SteveMayze/GoGoGo/MotorEncoderBoardBO/doc/WheelTest/Salea-R-Med-Zoomb.png

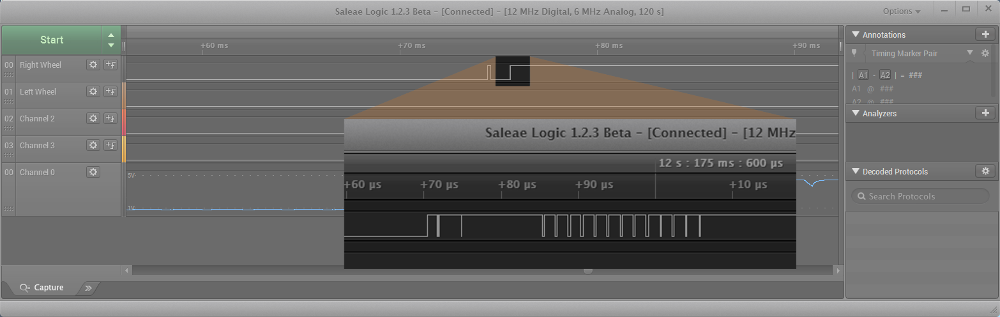
MotorEncoderBoardBO/doc/WheelTest/Salea-R-Med-Zoomb.png
