SteveMayze/GoGoGo/MotorEncoderBoardBO/doc/WheelTest/Rev5-assembly.jpg

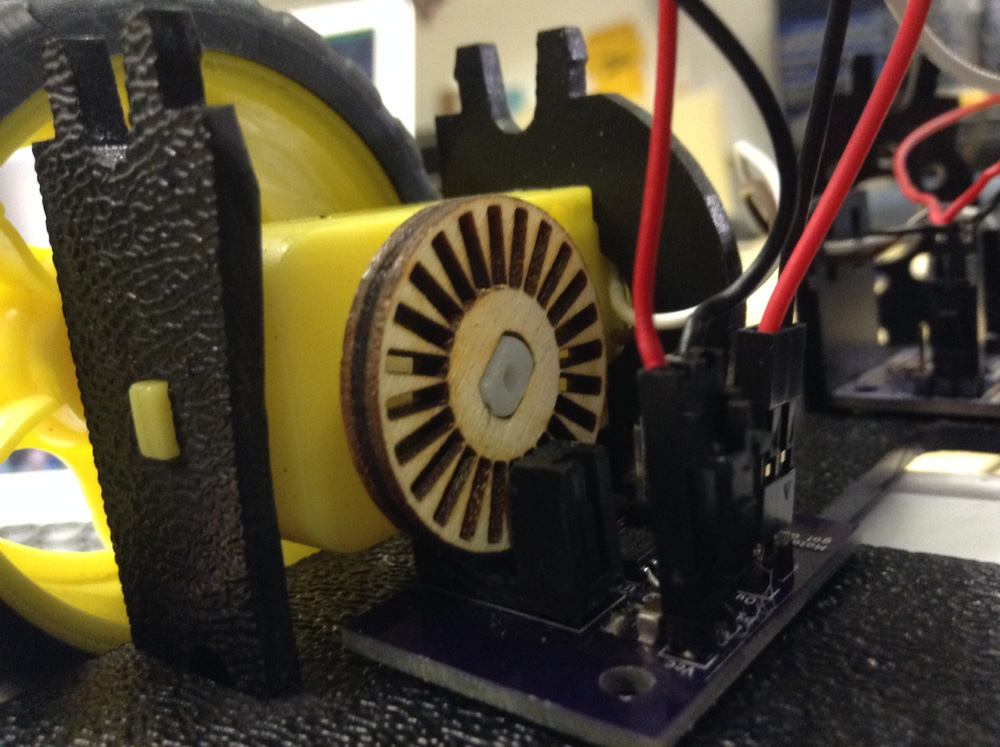
MotorEncoderBoardBO/doc/WheelTest/Rev5-assembly.jpg
