SteveMayze/GoGoGo/README.md

# GoGoGo
Motor driver module for the Roll With It Project.
