SteveMayze/GoGoGo/doc/Encoder-output-annotated.png

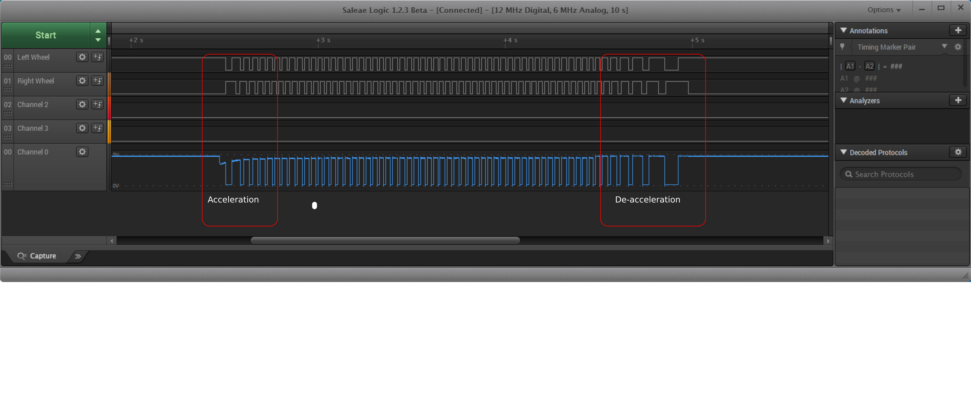
doc/Encoder-output-annotated.png
