SteveMayze/GoGoGo/doc/Encoder-output-detail.png

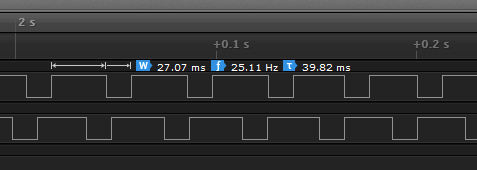
doc/Encoder-output-detail.png
