SteveMayze/GoGoGo/doc/Encoder-output-pwm.png

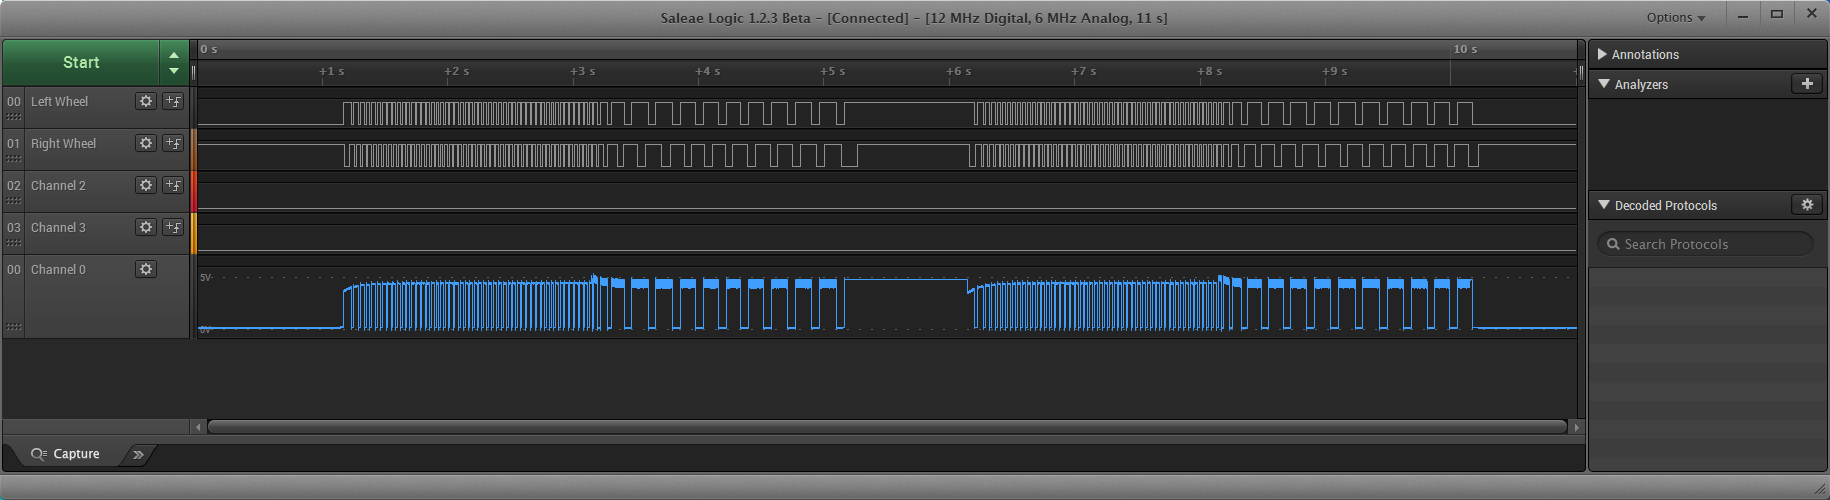
doc/Encoder-output-pwm.png
