SteveMayze/GoGoGo/doc/Forward-10-Fullspeed.png

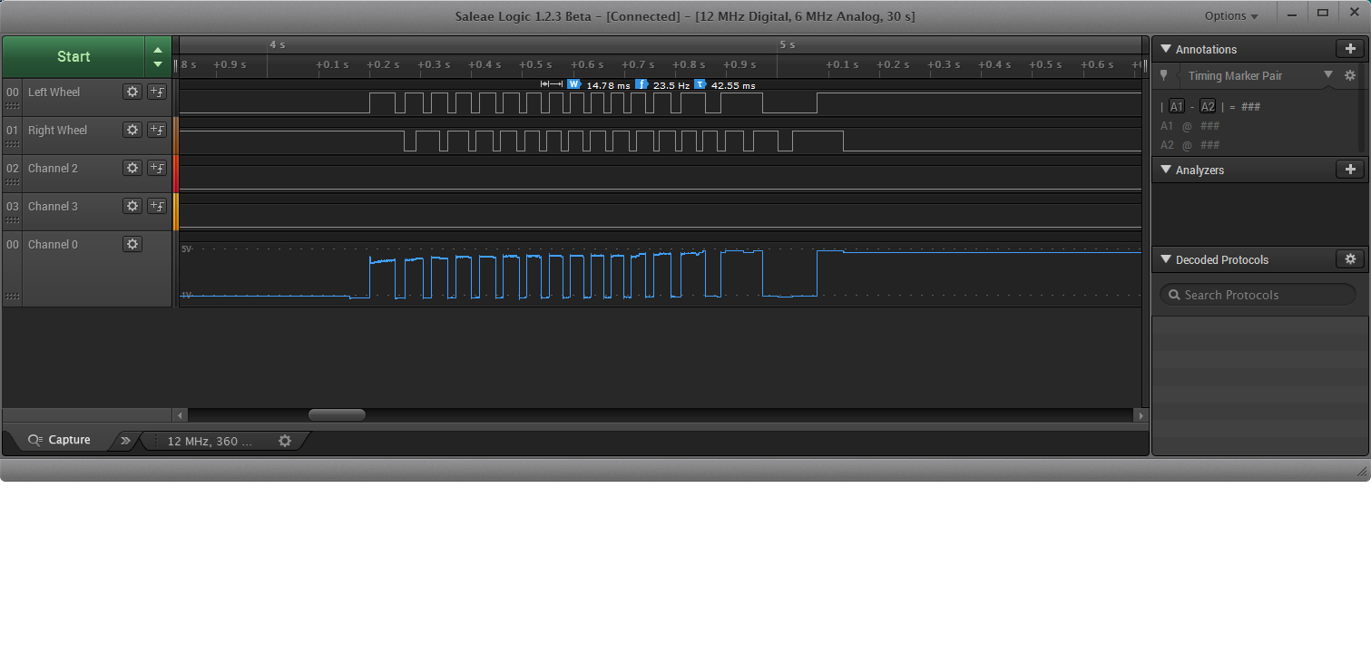
doc/Forward-10-Fullspeed.png
