SteveMayze/GoGoGo/doc/Forward-10-QuarterSpeed.png

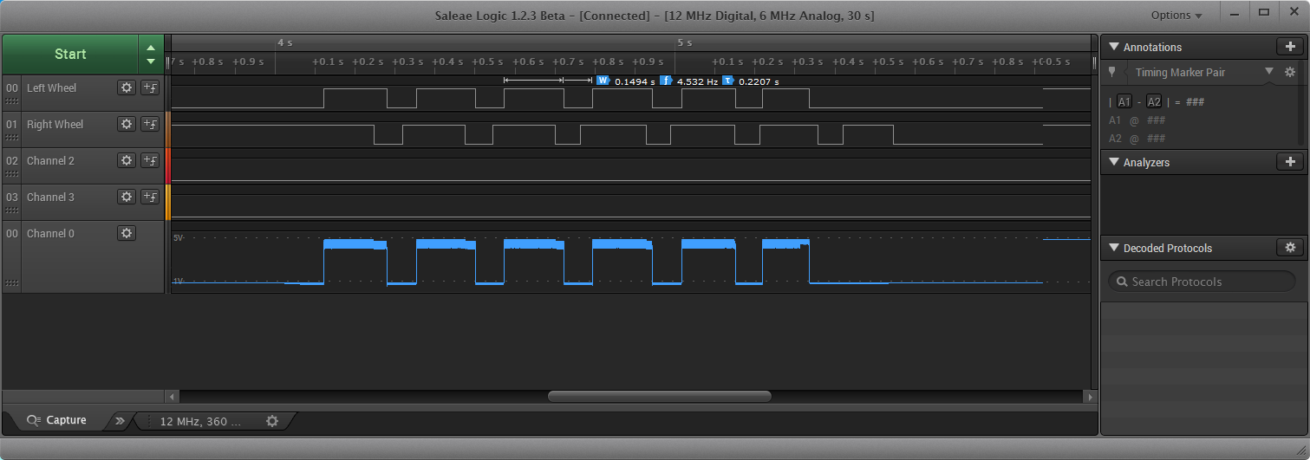
doc/Forward-10-QuarterSpeed.png
