SteveMayze/GoGoGo/doc/IMG_1161b.png

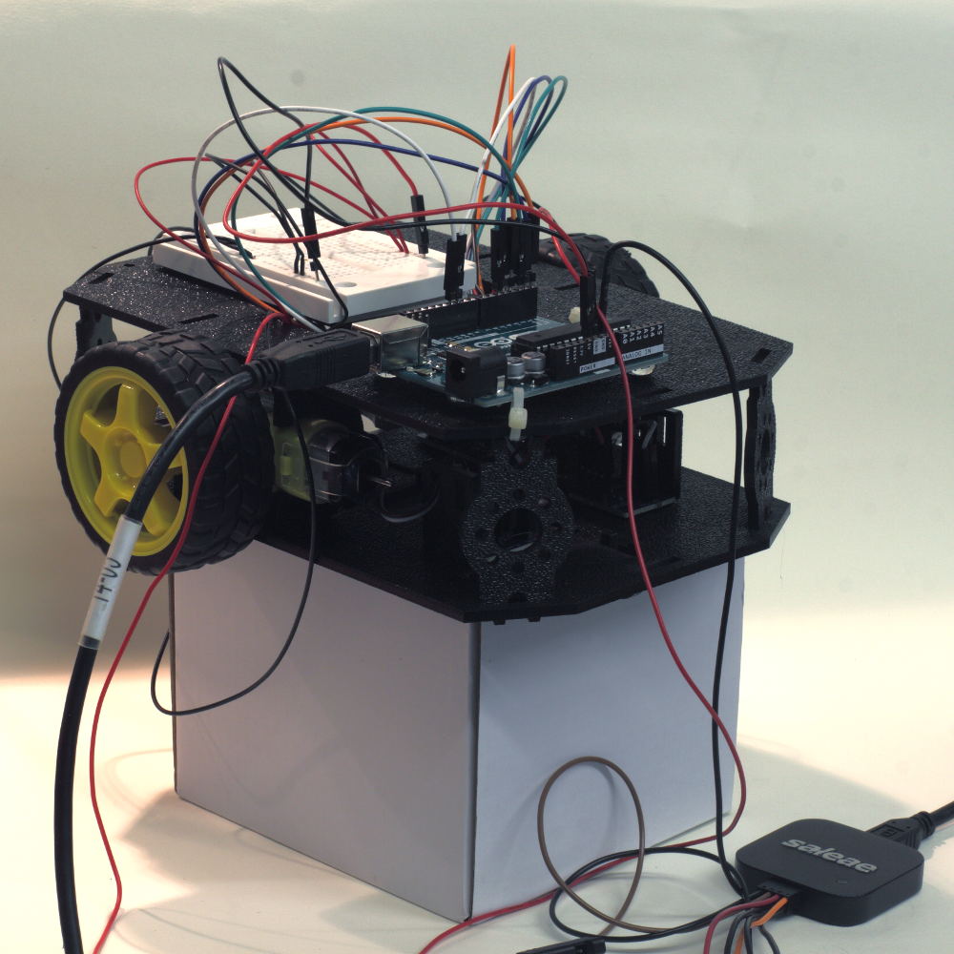
doc/IMG_1161b.png
