SteveMayze/GoGoGo/doc/motorDriver-Rev2.png

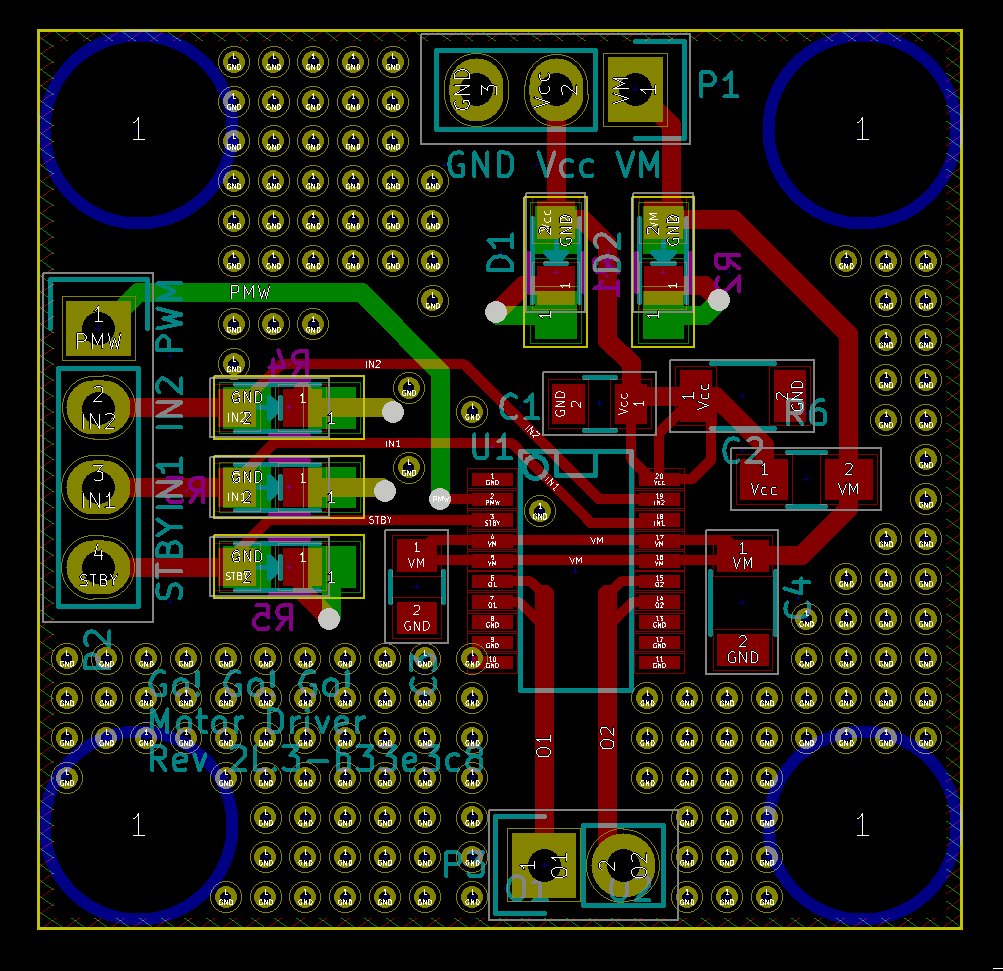
doc/motorDriver-Rev2.png
