SteveMayze/GoGoGo/doc/MotorFeedbackControl.png

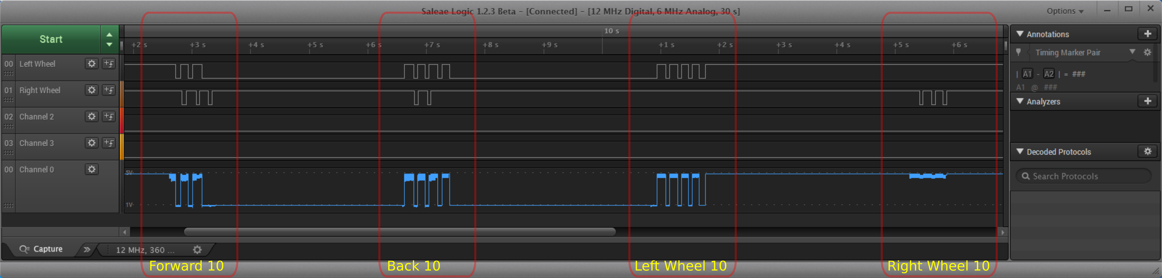
doc/MotorFeedbackControl.png
