SteveMayze/GoGoGo/doc/SynchronisedStart-Capture.png

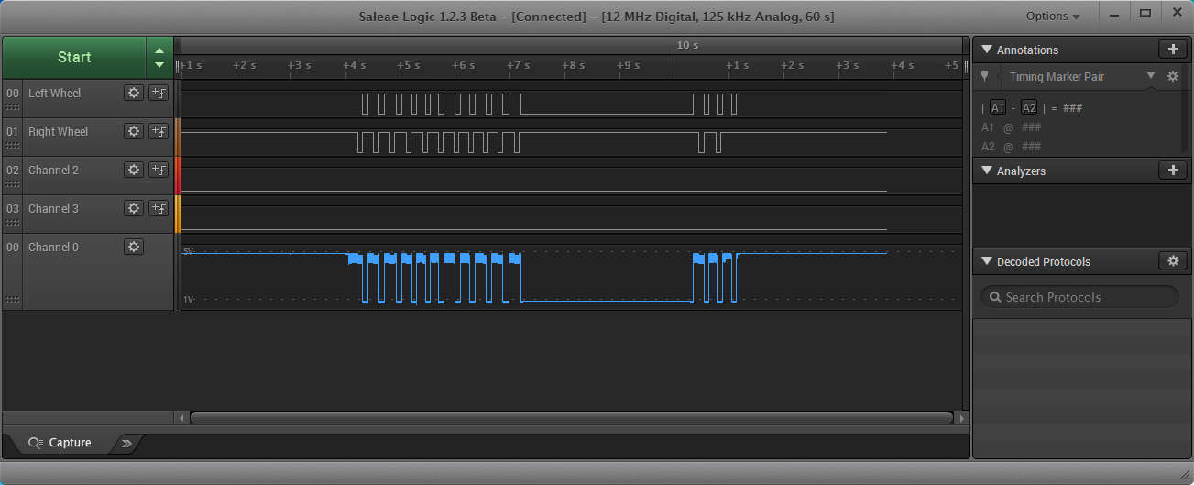
doc/SynchronisedStart-Capture.png
