SteveMayze/GoGoGo/MotorEncoderBoardBO/doc/Disk-PCB.png

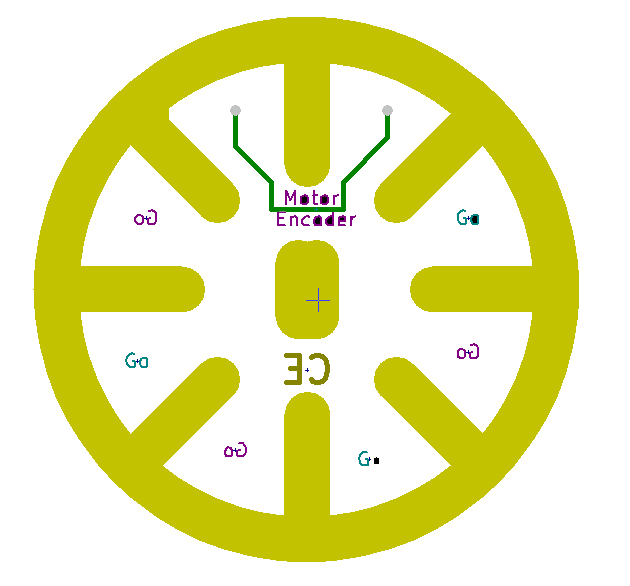
MotorEncoderBoardBO/doc/Disk-PCB.png
