SteveMayze/GoGoGo/MotorEncoderBoardBO/doc/Encoder-Datasheet.png

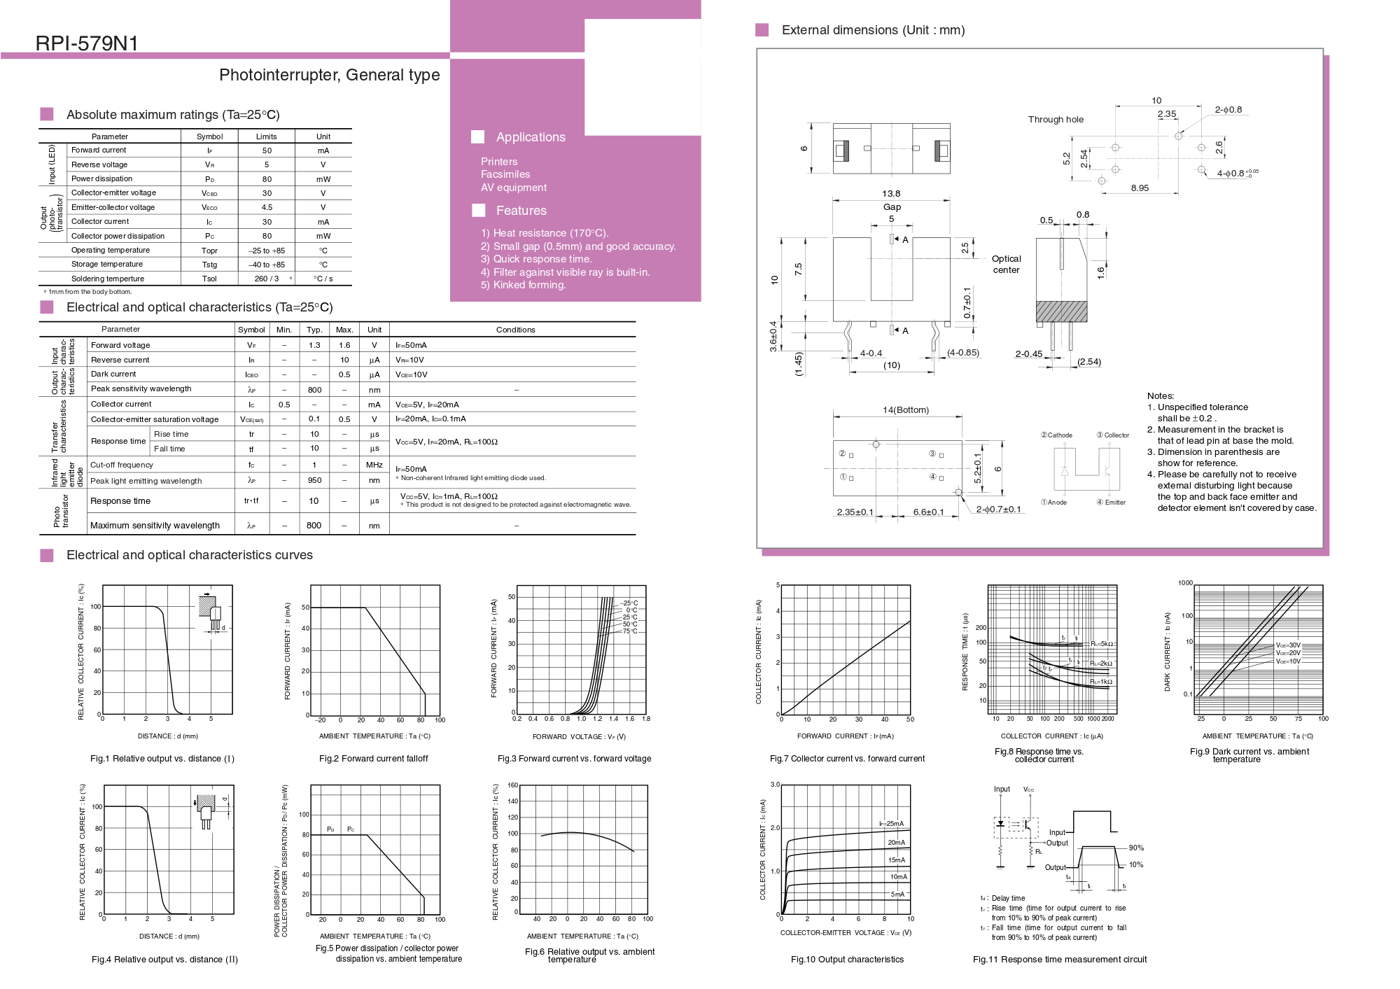
MotorEncoderBoardBO/doc/Encoder-Datasheet.png
