SteveMayze/GoGoGo/MotorEncoderBoardBO/doc/EncoderWheel-Laser-V01.jpg

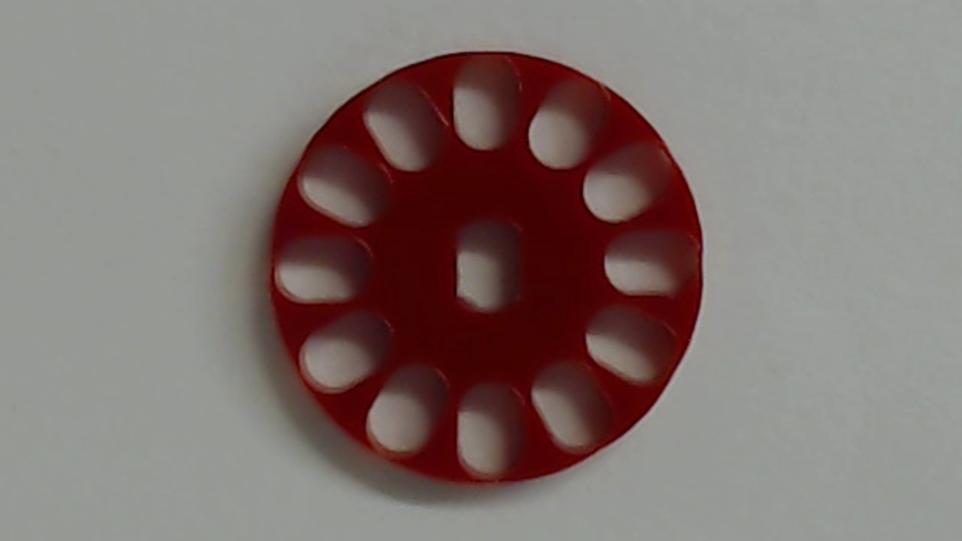
MotorEncoderBoardBO/doc/EncoderWheel-Laser-V01.jpg
