SteveMayze/GoGoGo/MotorEncoderBoardBO/doc/IMG_1146.png

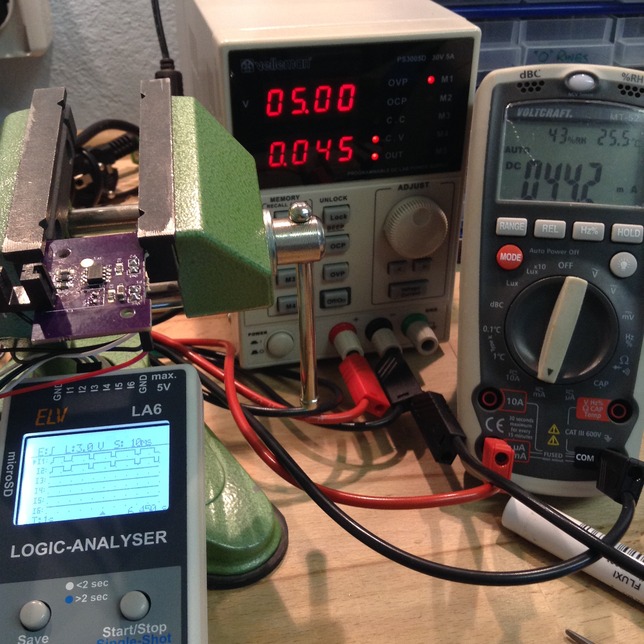
MotorEncoderBoardBO/doc/IMG_1146.png
