SteveMayze/GoGoGo/MotorEncoderBoardBO/doc/MotorEncoder-Connection.png

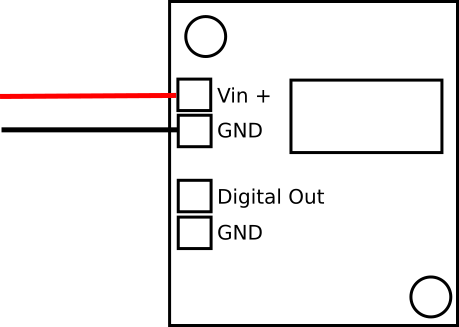
MotorEncoderBoardBO/doc/MotorEncoder-Connection.png
