SteveMayze/GoGoGo/MotorEncoderBoardBO/doc/Salea-L-100pF.png

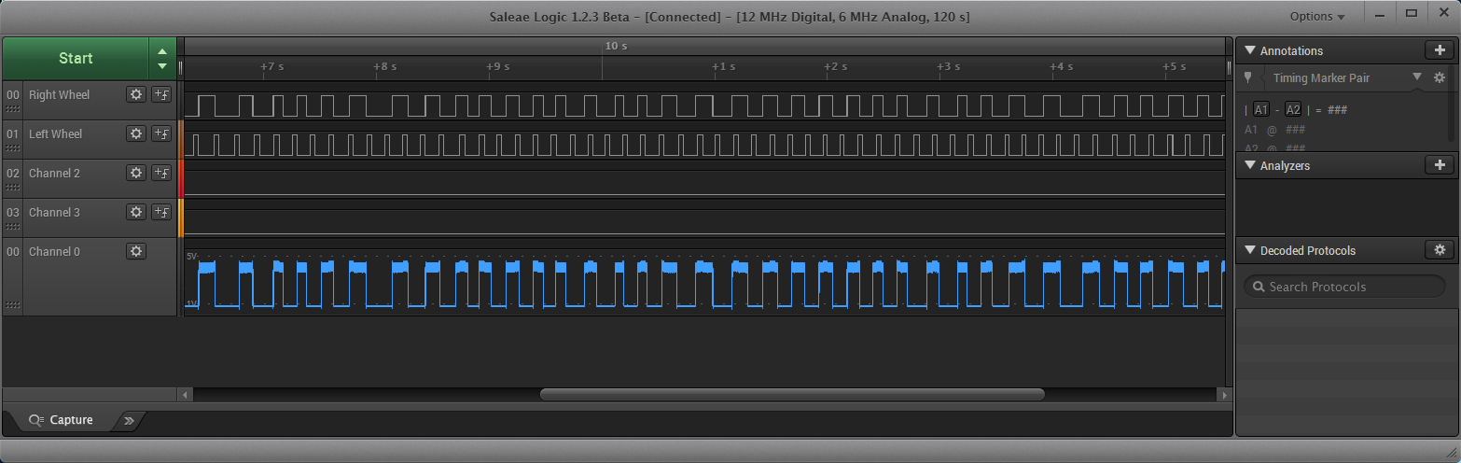
MotorEncoderBoardBO/doc/Salea-L-100pF.png
