SteveMayze/GoGoGo/MotorEncoderBoardBO/doc/Salea-R-100nF.png

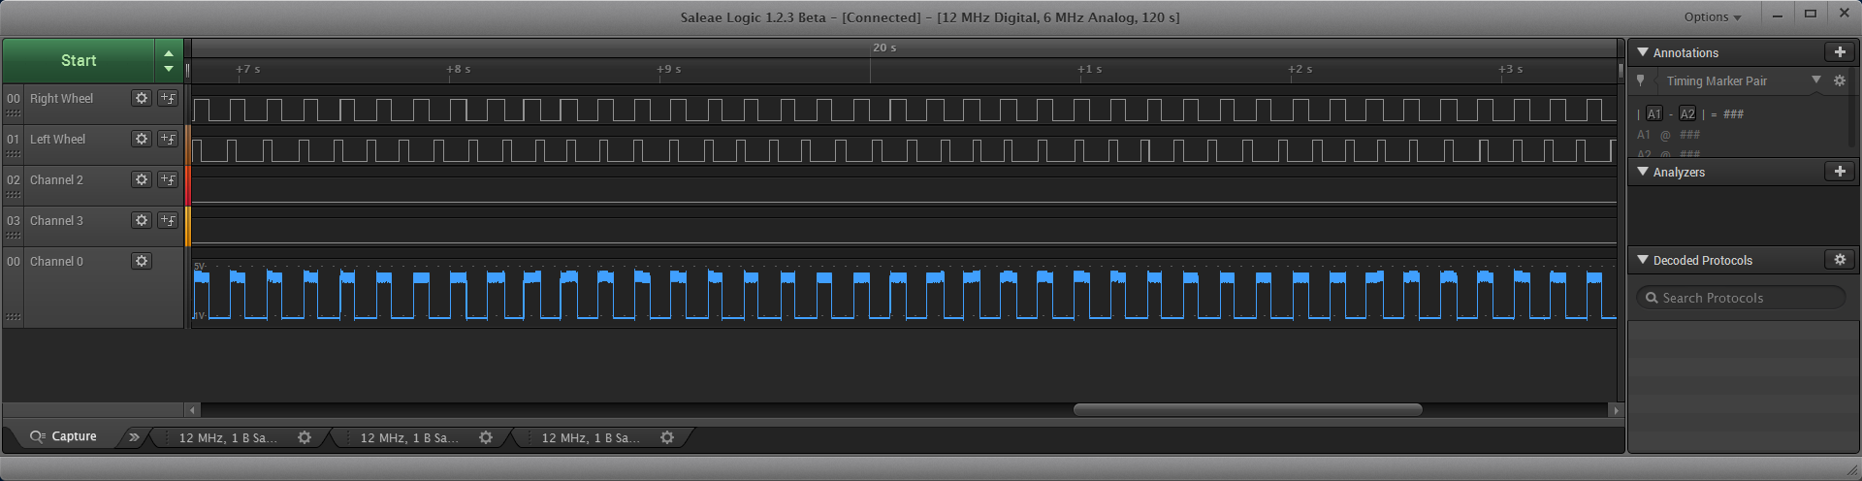
MotorEncoderBoardBO/doc/Salea-R-100nF.png
