SteveMayze/GoGoGo/MotorEncoderBoardBO/doc/Salea-R-Med-Zoom.png

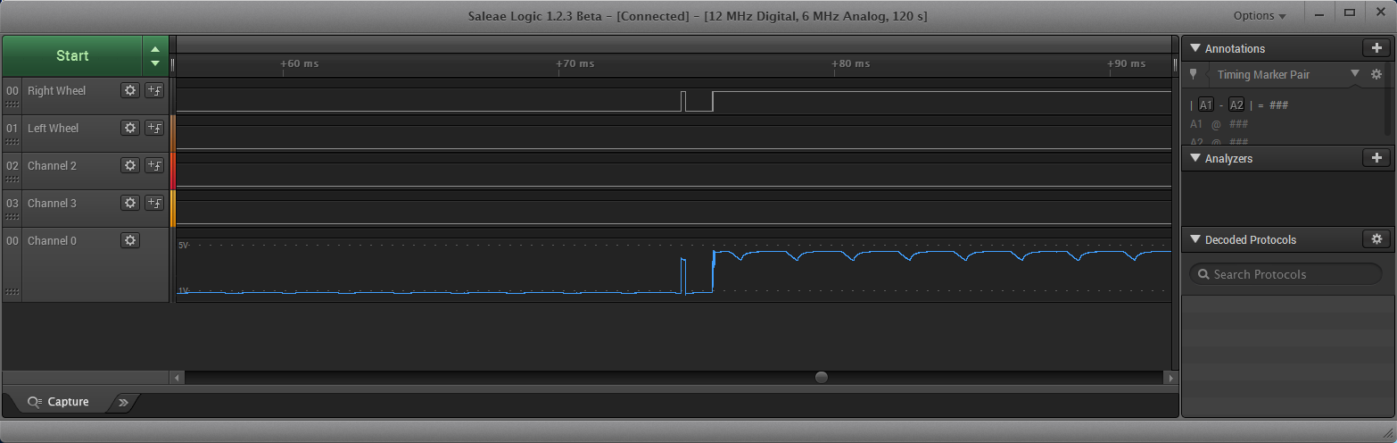
MotorEncoderBoardBO/doc/Salea-R-Med-Zoom.png
