SteveMayze/GoGoGo/MotorEncoderBoardBO/doc/Salea-R-Zoom.png

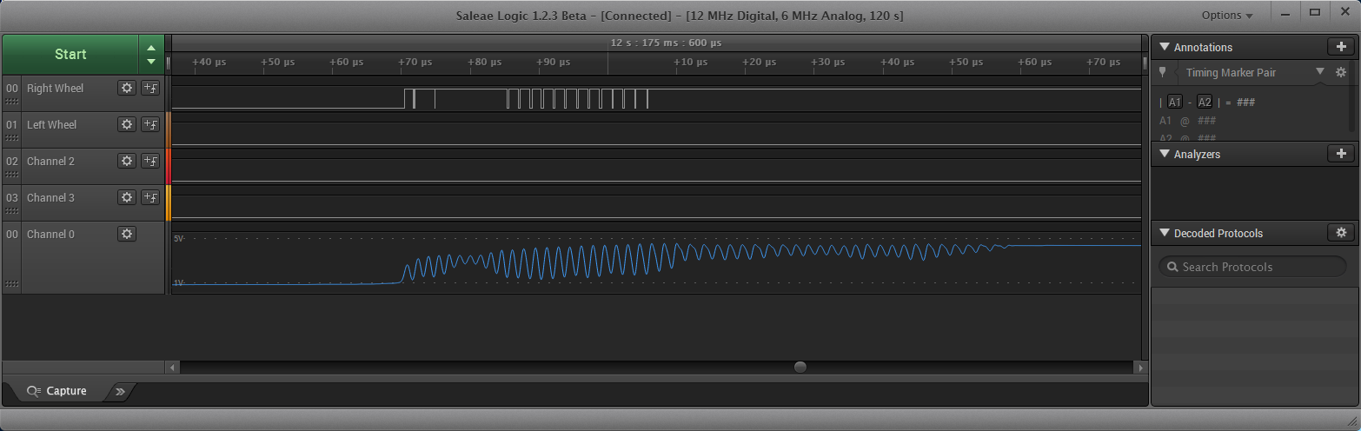
MotorEncoderBoardBO/doc/Salea-R-Zoom.png
