SteveMayze/GoGoGo/MotorEncoderDisk/image/EncoderWheel-Rev3-LCb.JPG

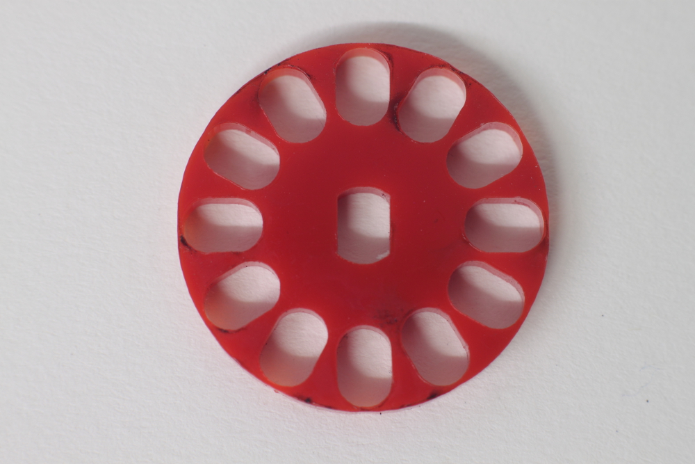
MotorEncoderDisk/image/EncoderWheel-Rev3-LCb.JPG
