SteveMayze/GoGoGo/MotorEncoderDisk/image/EncoderWheel-Rev4.png

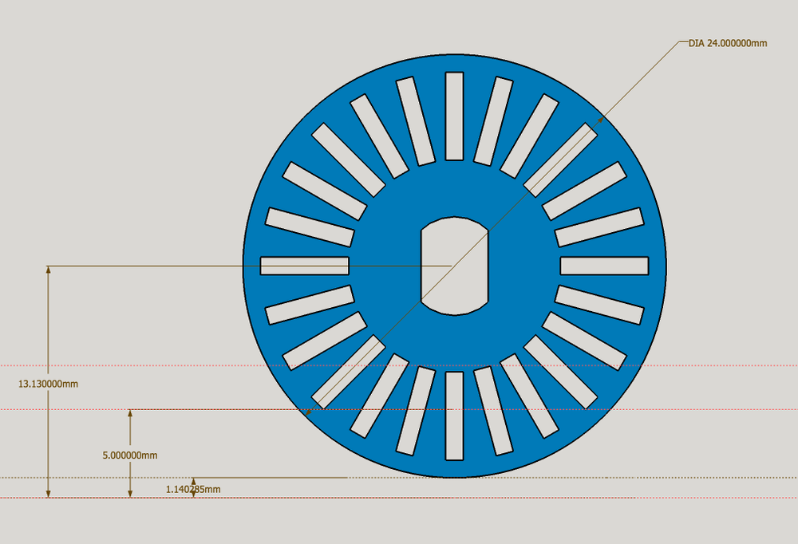
MotorEncoderDisk/image/EncoderWheel-Rev4.png
