SteveMayze/GoGoGo/MotorEncoderDisk/image/encoderWheel.png

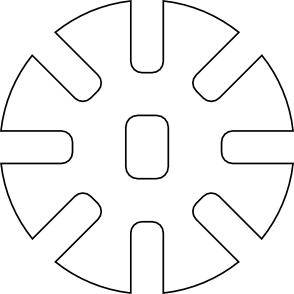
MotorEncoderDisk/image/encoderWheel.png
