SteveMayze/GoGoGo/(list of files, cad)

Other CAD files:
MotorEncoderDisk/image/EncoderWheel-Rev-Template.skp
MotorEncoderDisk/image/EncoderWheel-Rev-base.skp
MotorEncoderDisk/image/EncoderWheel-Rev2.skp
MotorEncoderDisk/image/EncoderWheel-Rev2~.skp
MotorEncoderDisk/image/EncoderWheel-Rev3.skp
MotorEncoderDisk/image/EncoderWheel-Rev3~.skp
MotorEncoderDisk/image/EncoderWheel-Rev4-Base.skp
MotorEncoderDisk/image/EncoderWheel-Rev4-su16.skp
MotorEncoderDisk/image/EncoderWheel-Rev4.skp
MotorEncoderDisk/image/EncoderWheel-Rev4b.skp
MotorEncoderDisk/image/EncoderWheel-Rev4~.skp
MotorEncoderDisk/image/EncoderWheel-Rev5-su16.skp
MotorEncoderDisk/image/EncoderWheel-Rev5.skp
MotorEncoderDisk/image/EncoderWheel-Rev5b.skp
MotorEncoderDisk/image/EncoderWheel-Rev5~.skp
MotorEncoderDisk/image/EncoderWheel-Rev6.skp
MotorEncoderDisk/image/EncoderWheel-Rev6~.skp
