SteveMayze/GoGoGo/MotorEncoderBoardBO/doc/WheelTest/Rev4-Assembly.jpg

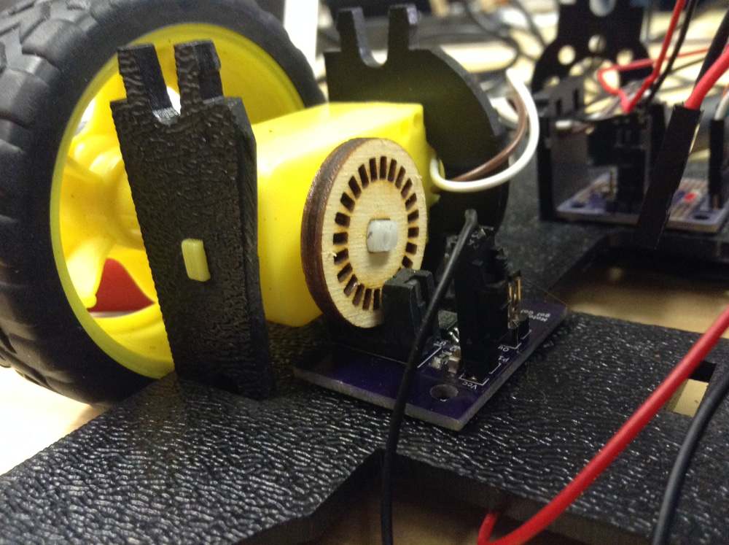
MotorEncoderBoardBO/doc/WheelTest/Rev4-Assembly.jpg
