SteveMayze/GoGoGo/doc/MotionTest.png

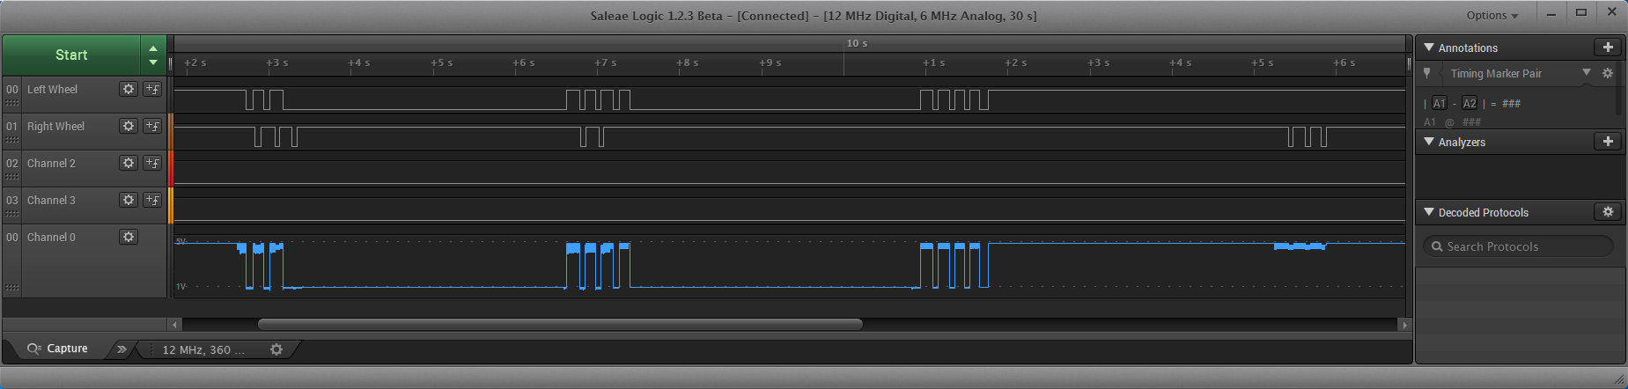
doc/MotionTest.png
