SteveMayze/GoGoGo/MotorEncoderBoardBO/doc/WheelTest/EncoderWheel-PCB.jpg

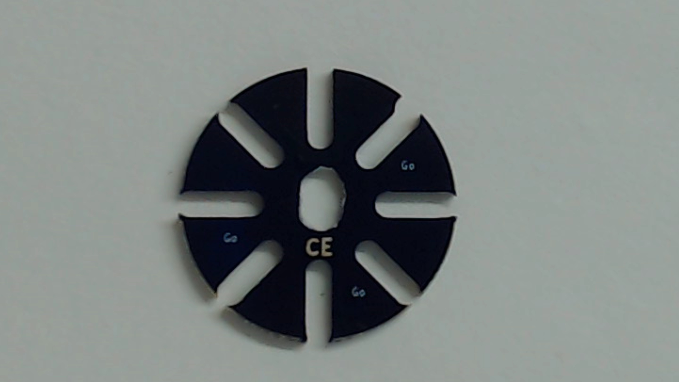
MotorEncoderBoardBO/doc/WheelTest/EncoderWheel-PCB.jpg
