SteveMayze/GoGoGo/MotorEncoderBoardBO/doc/WheelTest/Rev5-saleae.png

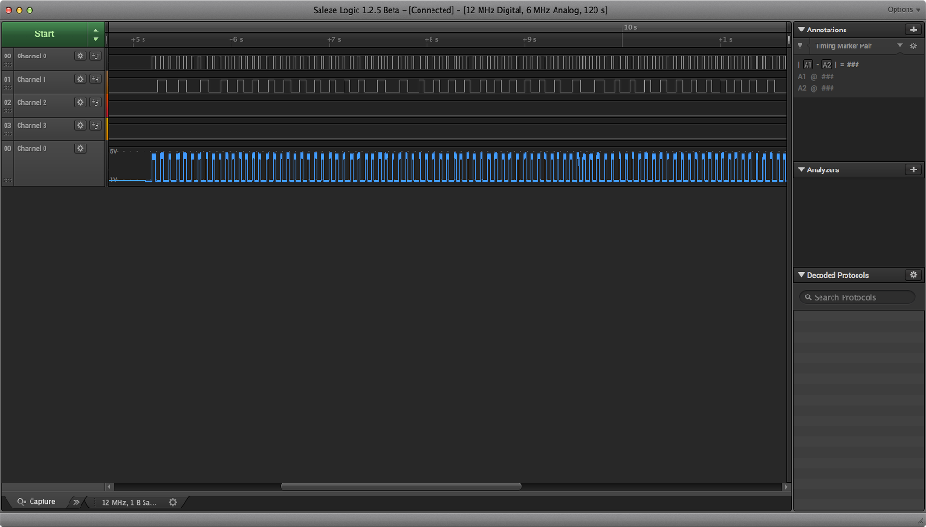
MotorEncoderBoardBO/doc/WheelTest/Rev5-saleae.png
