SteveMayze/GoGoGo/MotorEncoderBoardBO/doc/WheelTest/Rev5-saleae.tiff

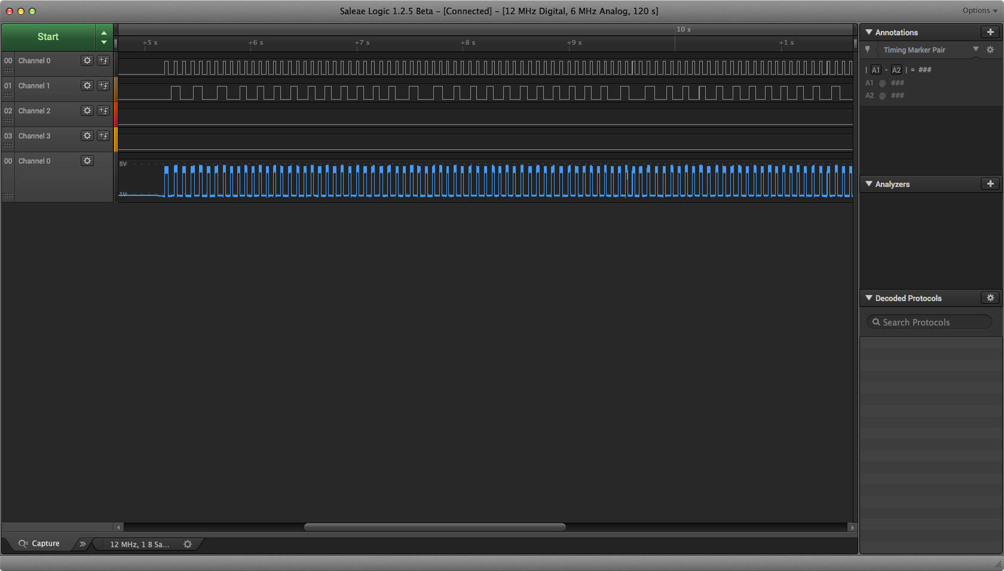
MotorEncoderBoardBO/doc/WheelTest/Rev5-saleae.tiff
