SteveMayze/GoGoGo/MotorEncoderBoardBO/MotorEncoderBoard.kicad_pcb

## KiCad design MotorEncoderBoardBO/MotorEncoderBoard.kicad_pcb (2016-05-20)

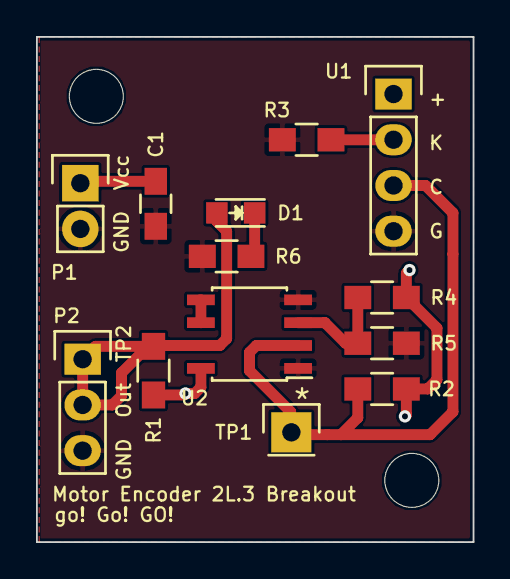
[picture p30: board MotorEncoderBoard.kicad_pcb from above]

Board: 2 copper layers, 24.3 x 28.1 mm, 13 parts (0 on the bottom side), 8 nets.

Parts:
C1: 10u; C_0805_HandSoldering
D1: Led_Small; LED_0805
P1: PWR; Pin_Header_Straight_1x02
P2: CONN_01X03; Pin_Header_Straight_1x03
R1, R4, R5: 1K; R_0805_HandSoldering
R2: 10K; R_0805_HandSoldering
R3: 100; R_0805_HandSoldering
R6: 470; R_0805_HandSoldering
TP1: OptoOut; Pin_Header_Straight_1x01
U1: RPI-579N1; Pin_Header_Straight_1x04
U2: LM311D; SOIC-8_3.9x4.9mm_Pitch1.27mm

Connections:
/OptoOut: R2.2, TP1.1, U1.3, U2.2
/Output: D1.2, P2.1, P2.2, R1.2, U2.7
GND: C1.2, P1.2, P2.3, R3.2, R5.2, R6.2, U1.4, U2.1, U2.4
unnamed: D1.1, R6.1
unnamed: R3.1, U1.2
unnamed: R4.2, R5.1, U2.3
unnamed: U2.5, U2.6
VCC: C1.1, P1.1, R1.1, R2.1, R4.1, U1.1, U2.8
