SteveMayze/GoGoGo/MotorEncoderBoardBO/EncoderBreakout.kicad_pcb

## KiCad design MotorEncoderBoardBO/EncoderBreakout.kicad_pcb (2016-04-19)

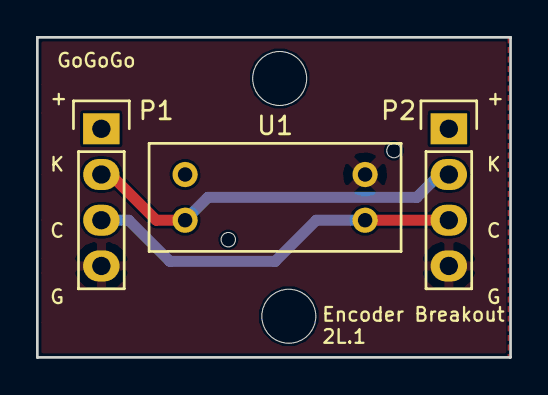
[picture p31: board EncoderBreakout.kicad_pcb from above]

Board: 2 copper layers, 26.3 x 17.8 mm, 3 parts (0 on the bottom side), 4 nets.

Parts:
P1, P2: CONN_01X04; Pin_Header_Straight_1x04
U1: RPI-579N1

Connections:
/Cathode: P1.2, P2.2, U1.2
/Collector: P1.3, P2.3, U1.3
/GND: P1.4, P2.4, U1.4
/Vcc: P1.1, P2.1, U1.1
