SteveMayze/GoGoGo/motorDriver/motorDriver.kicad_pcb

## KiCad design motorDriver/motorDriver.kicad_pcb (2015-11-27)

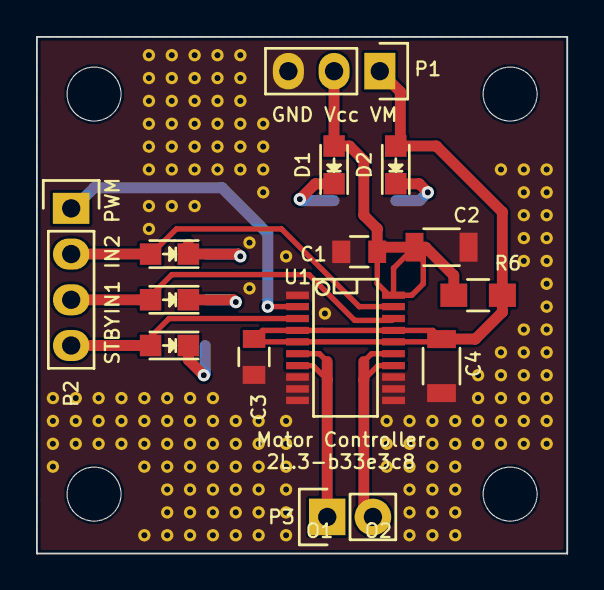
[picture p32: board motorDriver.kicad_pcb from above]

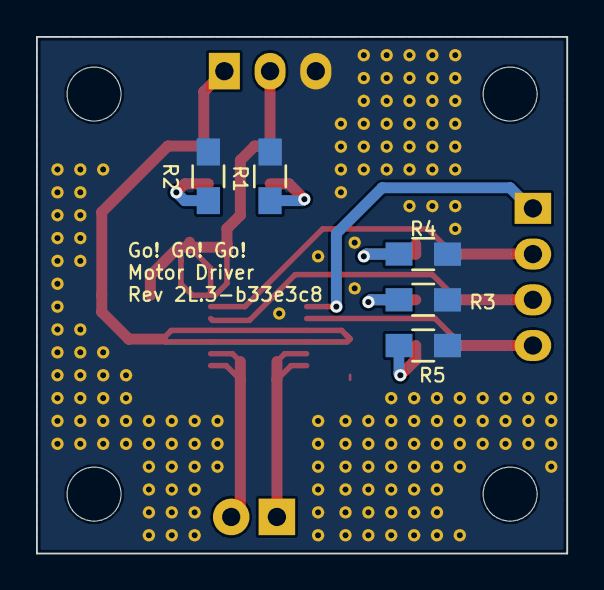
[picture p33: board motorDriver.kicad_pcb from below]

Board: 2 copper layers, 29.5 x 28.7 mm, 19 parts (5 on the bottom side), 14 nets.

Parts:
C1, C3: 0.1u; C_0805
C2, C4: 10u; C_1206
D1, D2, D3: LED; LED-0805
IN1, IN2: LED; LED-0805
P1: CONN_01X03; Pin_Header_Straight_1x03
P2: Input; Pin_Header_Straight_1x04
P3: Output; Pin_Header_Straight_1x02
R1, R2, R3, R4, R5: 1KΩ; R_0805_HandSoldering
R6: 0Ω; R_0805_HandSoldering
U1: TB6593FNG; SSOP-20

Connections:
/IN1: IN1.2, P2.3, U1.18
/IN2: IN2.2, P2.2, U1.19
/O1: P3.1, U1.6, U1.7
/O2: P3.2, U1.14, U1.15
/PMW: P2.1, U1.2
/STBY: D3.2, P2.4, U1.3
/VM: C3.1, C4.1, D2.2, P1.1, R6.2, U1.4, U1.5, U1.16, U1.17
/Vcc: C1.1, C2.1, D1.2, P1.2, R6.1, U1.20
GND: C1.2, C2.2, C3.2, C4.2, P1.3, R1.2, R2.2, R3.2, R4.2, R5.2, U1.1, U1.8, U1.9, U1.10, U1.11, U1.12, U1.13
unnamed: D1.1, R1.1
unnamed: D2.1, R2.1
unnamed: D3.1, R5.1
unnamed: IN1.1, R3.1
unnamed: IN2.1, R4.1
