SteveMayze/GoGoGo/firmware/Arduino/SteeringTest4/SteeringTest4.ino

#define cbi(sfr, bit) (_SFR_BYTE(sfr) &= ~_BV(bit))
#define sbi(sfr, bit) (_SFR_BYTE(sfr) != _BV(bit))

volatile unsigned long leftTick = 0;
volatile unsigned long rightTick = 0;
volatile bool stopLeft = false;
volatile bool stopRight = false;
volatile unsigned long lTickLimit = 0;
volatile unsigned long rTickLimit = 0;


String cmdStr;
String msg = "@ ";
char cmd[5];

int lpwmPin = 9; // PWM ~9
int lstbyPin = 5; // PD5
int linp1 = 13;
int linp2 = 12;
int lwheel = 2;
int lTrim = 0;

int lTrimValue = 0;
int lTare = 0;

int rpwmPin = 10; // PWM ~10
int rstbyPin = 4; // PD4
int rinp1 = 6;
int rinp2 = 7;
int rwheel = 3;
int rTrim = 1;

int rTrimValue = 0;
int rTare = 0;

bool leftRunning = false;
bool rightRunning = false;

int speed = 60;
int lspeed = 60;
int rspeed = 60;

void isr_leftTick();
void isr_rightTick();

void setup() {
  Serial.begin(9600);

  pinMode(lwheel, INPUT);
  digitalWrite(lwheel, HIGH);

  pinMode(rwheel, INPUT);
  digitalWrite(rwheel, HIGH);

  pinMode(lstbyPin, OUTPUT);
  pinMode(linp1, OUTPUT);
  pinMode(linp2, OUTPUT);
  pinMode(lpwmPin, OUTPUT);

  // Right
  pinMode(rstbyPin, OUTPUT);
  pinMode(rinp1, OUTPUT);
  pinMode(rinp2, OUTPUT);
  pinMode(rpwmPin, OUTPUT);

  pinMode(lwheel, OUTPUT);
  pinMode(rwheel, OUTPUT);
  
  attachInterrupt(digitalPinToInterrupt(lwheel), isr_leftTick, FALLING);
  attachInterrupt(digitalPinToInterrupt(rwheel), isr_rightTick, FALLING);
  
  leftRunning = false;
  rightRunning  = false;
}


void setSpeed(int wheel, int speed) {
  int calibratedValue = 0;
  if (wheel == lpwmPin) {
      lspeed = speed;
      msg = "Setting RIGHT ";
      calibratedValue = getCalibratedSpeed(lspeed, analogRead(lTrim), lTare);
  } else {
      rspeed = speed;
      msg = "Setting RIGHT ";
      calibratedValue = getCalibratedSpeed(rspeed, analogRead(rTrim), rTare);
  }
  analogWrite(wheel, calibratedValue);
}

int getCalibratedSpeed(int speed, int trimmer, int tare){
  int calibratedValue = 0;
  double cx = 0.0;
      cx = ((trimmer - 512) * -1) + tare;
      cx = cx / 512;
      calibratedValue = speed + (cx * 127);
      calibratedValue = (calibratedValue < 0 ? 0 :  (calibratedValue > 255 ? 255 : calibratedValue));
      msg = msg + "speed=" + speed + ", Calibrated value=" + calibratedValue + ", cx=" + cx;
  Serial.println(msg);
  return calibratedValue;  
}


void ysetSpeed(int wheel, int speed) {
  int calibratedValue = 0;
  int cx = 0;
  
  if (wheel == lpwmPin) {
      lspeed = speed;
      calibratedValue = lspeed;
      msg = "";
      msg = msg + "Setting LEFT speed=" + lspeed + ", Calibrated value=" + calibratedValue;
  } else {
    rspeed = speed; // * 1.25;
      calibratedValue = rspeed;
      msg = "";
      msg = msg + "Setting RIGHT speed=" + rspeed + ", Calibrated value=" + calibratedValue;
  }
  Serial.println(msg);
  analogWrite(wheel, calibratedValue);
}




void forward( int speed, int ticks ) {
  msg = "";
  msg = msg + "FORWARD ... speed=" + speed + ", ticks=" + ticks;
  Serial.println(msg);
  rightWheel(true, speed, ticks);
  leftWheel(true, speed, ticks);
  PORTD |= B00110000;
}

void reverse(int speed, int ticks) {
  msg = "";
  msg = msg + "BACK ... speed=" + speed + ", ticks=" + ticks;
  Serial.println(msg);
  leftWheel(false, speed, ticks);
  rightWheel(false, speed, ticks);
  PORTD |= B00110000;

}

void rightWheel(boolean forward, int speed, int limit) {
  rTickLimit = limit;
  rightTick = 0;
  msg = "";
  if (forward == true) {
    msg = msg + "RIGHT Forward ... speed=" + speed + ", ticks=" + limit;
    Serial.println(msg);
    digitalWrite(rinp1, LOW);
    digitalWrite(rinp2, HIGH);
  } else {
    msg = msg + "LEFT Back ... speed=" + speed + ", ticks=" + limit;
    Serial.println(msg);
    digitalWrite(rinp1, HIGH);
    digitalWrite(rinp2, LOW);
  }
  // digitalWrite(rstbyPin, HIGH);
  setSpeed(rpwmPin, speed);
  rightRunning = true;
  stopRight = false;

}



void leftWheel(boolean forward, int speed, int limit) {
  lTickLimit = limit;
  leftTick = 0;
  msg = "";
  if (forward == true) {
    msg = msg + "LEFT Forward ... speed=" + speed + ", ticks=" + limit;
    Serial.println(msg);
    digitalWrite(linp1, LOW);
    digitalWrite(linp2, HIGH);
  }
  else {
    msg = msg + "RIGHT Back ... speed=" + speed + ", ticks=" + limit;
    Serial.println(msg);
    digitalWrite(linp1, HIGH);
    digitalWrite(linp2, LOW);
  }
  // digitalWrite(lstbyPin, HIGH);
  setSpeed(lpwmPin, speed);
  leftRunning = true;
  stopLeft = false;
}


void allStop() {
  PORTD &= B11001111;
  Serial.println("ALL STOP!");
  // leftStop();
  // rightStop();
  lTickLimit = 0;
  leftTick = 1;
  leftRunning = false;
  rTickLimit = 0;
  rightTick = 1;
  rightRunning = false;
}

void leftStop() {
  msg = "";
  msg = msg + "LEFT STOP! leftRunning=" + leftRunning + ", leftTick=" + leftTick + " lTickLimit=" + lTickLimit +
        " rightRunning=" + rightRunning + ", rightTick=" + rightTick + " rTickLimit=" + rTickLimit;
  Serial.println(msg);
  digitalWrite(linp1, HIGH);
  digitalWrite(linp2, HIGH);
  digitalWrite(lstbyPin, HIGH);
  lTickLimit = 0;
  leftTick = 1;
  leftRunning = false;
}

void rightStop() {
  msg = "";
  msg = msg + "RIGHT STOP! leftRunning=" + leftRunning + ", leftTick=" + leftTick + " lTickLimit=" + lTickLimit +
        " rightRunning=" + rightRunning + ", rightTick=" + rightTick + " rTickLimit=" + rTickLimit;
  Serial.println(msg);
  digitalWrite(rinp1, HIGH);
  digitalWrite(rinp2, HIGH);
  digitalWrite(rstbyPin, HIGH);
  rTickLimit = 0;
  rightTick = 1;
  rightRunning = false;
}


void loop() {
  int newCmd = false;
  int param = 0;
  if (Serial.available() > 0)
  {
    cmdStr = Serial.readStringUntil(' ');
    param = Serial.parseInt();
    cmdStr.toCharArray(cmd, 5);
    newCmd = true;
  }
  if (newCmd) {
    msg = "";
    switch (cmd[0]) {
      case 'f':
        forward(speed, param);
        break;
      case 'b':
        reverse(speed, param);
        break;
      case 'r':
        switch (cmd[1]) {
          case 'b':
            leftStop();
            rightWheel(false, speed, param);
            digitalWrite(rstbyPin, HIGH);
            break;
          case 'c': //Calibrate
            rTare = analogRead(rTrim) -512; // This becomes the new 0.
            msg = "";
            msg = msg + "Centering RIGHT by " + rTare;
            Serial.println(msg);
            break;
          default:
            leftStop();
            rightWheel(true, speed, param);
            digitalWrite(rstbyPin, HIGH);
            break;
        }
        break;
      case 'l':
        switch (cmd[1]) {
          case 'b':
            rightStop();
            leftWheel(false, speed, param);
            digitalWrite(lstbyPin, HIGH);
            break;
          case 'c': //Calibrate
            lTare =  analogRead( lTrim ) - 512; // This becomes the new 0.
            msg = "";
            msg = msg + "Centering LEFT by " + lTare;
            Serial.println(msg);
            break;
          default:
            rightStop();
            leftWheel(true, speed, param);
            digitalWrite(lstbyPin, HIGH);
            break;
        }
        break;
      case 's':
        speed = param;
        Serial.println(msg);
        switch (cmd[1]) {
          case 'l':
            setSpeed(lpwmPin, speed);
            msg = msg + "LEFT Speed " + param + " units";
            break;
          case 'r':
            setSpeed(rpwmPin, speed);
            msg = msg + "RIGHT Speed " + param + " units";
            break;
          default:
            setSpeed(lpwmPin, speed);
            setSpeed(rpwmPin, speed);
            msg = "";
            msg = msg + "Speed " + param + " units";
            break;
        }
        Serial.println(msg);
        break;
      case 'q':
        msg = msg + "DUMP\n=======================" +
              "\nSpeed " + speed +
              "\nleftTick=" + leftTick +
              "\nrightTick=" + rightTick +
              "\nlTickLimit=" + lTickLimit +
              "\nrTickLimit=" + rTickLimit +
              "\nleftRunning=" + leftRunning +
              "\nrightRunning=" + rightRunning + 
              "\nlTare=" + lTare +
              "\nrTare=" + rTare + 
              "\nlspeed=" + lspeed +
              "\nrspeed=" + rspeed;
        Serial.println(msg);
        break;
      case 'h':
        switch (cmd[1]) {
          case 'l':
            rightStop();
            break;
          case 'r':
            leftStop();
            break;
          default:
            msg = msg + "HALT!";
            allStop();
            break;
        }
        break;
      default:
        msg = msg +  "Command " + cmdStr + " is not yet implemented";
        break;
    }
    newCmd = false;
  }

  if ( leftRunning || rightRunning ) {
    msg = "";
    msg = msg + "RUNNING leftRunning=" + leftRunning + ", leftTick=" + leftTick + " lTickLimit=" + lTickLimit +
          " rightRunning=" + rightRunning + ", rightTick=" + rightTick + " rTickLimit=" + rTickLimit;
    Serial.println(msg);
    if (stopRight && rightRunning ) {
      rightStop();
    }
    if ( stopLeft && leftRunning ) {
      leftStop();
    }
  }
}


void isr_leftTick() {
  ++leftTick;
  stopLeft = leftTick > lTickLimit;
}

void isr_rightTick() {
  ++rightTick;
  stopRight = rightTick > rTickLimit;
}
