SteveMayze/GoGoGo/(commit log)

2015-06-15 Initial checkin
    [GoGoGo.sch]
2015-06-15 Schemantic done
    [GoGoGo.sch]
2015-06-15 Initial layout
    [GoGoGo.kicad_pcb, GoGoGo.sch]
2015-06-16 Main layout done
    [GoGoGo.kicad_pcb]
2015-06-16 Gerbers created
    [GoGoGo-B_Cu.gbl, GoGoGo-B_Mask.gbs, GoGoGo-B_Paste.gbp, GoGoGo-B_SilkS.gbo, GoGoGo-Edge_Cuts.gbr, GoGoGo-Edge_Cuts.gko, GoGoGo-F_Cu.gtl, GoGoGo-F_Mask.gts]
2015-06-27 Motor encoder board inital checking
    [MotorEncoderBoard.sch]
2015-06-28 Schematic done
    [MotorEncoderBoard.sch]
2015-06-28 Layout for motor encoder board done
    [MotorEncoderBoard-B_Cu.gbl, MotorEncoderBoard-B_Cu.gbr, MotorEncoderBoard-B_Paste.gbp, MotorEncoderBoard-B_Paste.gbr, MotorEncoderBoard-B_SilkS.gbo, MotorEncoderBoard-B_SilkS.gbr, MotorEncoderBoard-Edge_Cuts.gbr, MotorEncoderBoard-F_Cu.gbr]
2015-06-28 Added the encoder wheel
    [EncoderDisk-B_Cu.gbl, EncoderDisk-B_Mask.gbs, EncoderDisk-B_SilkS.gbo, EncoderDisk-Edge_Cuts.gbr, EncoderDisk-F_Cu.gtl, EncoderDisk-F_Mask.gts, EncoderDisk-F_SilkS.gto, EncoderDisk.drl]
2015-07-01 Combined the motor controller and encoder onto one board
    [MotorEncoderBoard.sch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]
2015-07-30 Made corrections to the board based on the video on testing
    [GoGoGo.csv, GoGoGo.kicad_pcb, GoGoGo.ods, GoGoGo.sch, MotorEncoderBoard.csv, MotorEncoderBoard.ods, MotorEncoderBoard.sch, MotorEncoderBoard.xml]
2015-08-01 Added a small correction to a route
    [GoGoGo.kicad_pcb]
2015-08-01 Correction to the motor encoder board
    [MotorEncoderBoard.kicad_pcb, MotorEncoderBoard.sch]
2015-08-03 Regenerated Gerbers for new boards and stensils
    [MotorEncoderBoard-B_Cu.gbl, MotorEncoderBoard-B_Cu.gbr, MotorEncoderBoard-B_Mask.gbs, MotorEncoderBoard-B_Paste.gbp, MotorEncoderBoard-B_Paste.gbr, MotorEncoderBoard-B_SilkS.gbo, MotorEncoderBoard-Edge_Cuts.gko, MotorEncoderBoard-F_Cu.gbr]
2015-08-04 Added changed the 100Ohm to 10kOhm for the sense resistor
    [MotorEncoderBoard.sch]
2015-08-29 Update to circuit
2015-08-29 Final corrections after testing
    [MotorEncoderBoard.kicad_pcb, MotorEncoderBoard.sch]
2015-09-26 Added firmware and test results
    [SNORE.CFG]
2015-10-05 Renamed kicad to motorDriver
    [GoGoGo-B_Cu.gbl, GoGoGo-B_Mask.gbs, GoGoGo-B_Paste.gbp, GoGoGo-B_SilkS.gbo, GoGoGo-Edge_Cuts.gbr, GoGoGo-Edge_Cuts.gko, GoGoGo-F_Cu.gtl, GoGoGo-F_Mask.gts]
2015-10-05 Renamed the GoGoGo files to motorDriver
    [motorDriver.csv, motorDriver.kicad_pcb, motorDriver.ods, motorDriver.sch, motorDriver.xml]
2015-10-05 Updated layout for Rev 2
    [motorDriver.kicad_pcb, motorDriver.sch]
2015-10-05 Generated Gerbers for Rev2
    [GoGoGo-B_Cu.gbl, GoGoGo-B_Mask.gbs, GoGoGo-B_Paste.gbp, GoGoGo-B_SilkS.gbo, GoGoGo-Edge_Cuts.gbr, GoGoGo-Edge_Cuts.gko, GoGoGo-F_Cu.gtl, GoGoGo-F_Mask.gts]
2015-10-05 Shifted the title label to the back
    [motorDriver-B_Cu.gbl, motorDriver-B_Mask.gbs, motorDriver-B_Paste.gbp, motorDriver-B_SilkS.gbo, motorDriver-Edge_Cuts.gko, motorDriver-F_Cu.gtl, motorDriver-F_Mask.gts, motorDriver-F_Paste.gtp]
2015-10-21 Corrected a stitching via on ground pins
    [motorDriver.kicad_pcb]
2015-11-27 Gerbers and small label changes
    [motorDriver-B_Cu.gbl, motorDriver-B_Mask.gbs, motorDriver-B_Paste.gbp, motorDriver-B_SilkS.gbo, motorDriver-Edge_Cuts.gm1, motorDriver-F_Cu.gtl, motorDriver-F_Mask.gts, motorDriver-F_Paste.gtp]
2015-11-27 Removed some stitch vias from near other footprints
    [motorDriver.kicad_pcb]
2015-12-23 Encoder wheel design update
    [EncoderWheel-Rev-Template.skp, EncoderWheel-Rev2.skp, EncoderWheel-Rev2~.skp, EncoderWheel-Rev3.skp, EncoderWheel-Rev3~.skp]
2015-12-25 Updated the encoder wheel design for smaller slots
    [EncoderWheel-Rev-base.skp, EncoderWheel-Rev4-Base.skp, EncoderWheel-Rev4.skp, EncoderWheel-Rev4~.skp, EncoderWheel-Rev5.skp, EncoderWheel-Rev5~.skp]
2015-12-28 Added a default speed to the SteeringTest2 as well as immediate stop signals
2016-01-08 Test results and wheel design changes
    [EncoderWheel-Rev4-su16.skp, EncoderWheel-Rev5-su16.skp]
2016-01-08 Created the version b of rev 4 and 5 and created the appropriate SVG files
    [EncoderWheel-Rev4b.skp, EncoderWheel-Rev5b.skp]
2016-01-10 Testing of the new wheel revisions
    [EncoderWheel-Rev4.skp, EncoderWheel-Rev4~.skp]
2016-01-16 Created the revision 6 of the encoder wheel - 0.5mm slots
    [EncoderWheel-Rev6.skp, EncoderWheel-Rev6~.skp]
2016-04-19 Created the encorder breakout
    [EncoderBreakout-B.Cu.GBL, EncoderBreakout-B.Mask.GBS, EncoderBreakout-B.SilkS.GBO, EncoderBreakout-Edge.Cuts.GKO, EncoderBreakout-F.Cu.gbr, EncoderBreakout-F.Mask.GTS, EncoderBreakout-F.SilkS.GTO, EncoderBreakout.drl]
2016-04-21 Copied the Encoder Board to a new directory to start a break-out version. Created Gerbers and ordered the board 2L.3Breakout
    [EncoderBreakout-B.Cu.GBL, EncoderBreakout-B.Mask.GBS, EncoderBreakout-B.SilkS.GBO, EncoderBreakout-Edge.Cuts.GKO, EncoderBreakout-F.Cu.gbr, EncoderBreakout-F.Mask.GTS, EncoderBreakout-F.SilkS.GTO, EncoderBreakout.drl]
2016-04-22 Removed the breakout artifacts from the MotorEncoderBoard directory
    [EncoderBreakout-B.Cu.GBL, EncoderBreakout-B.Mask.GBS, EncoderBreakout-B.SilkS.GBO, EncoderBreakout-Edge.Cuts.GKO, EncoderBreakout-F.Cu.gbr, EncoderBreakout-F.Mask.GTS, EncoderBreakout-F.SilkS.GTO, EncoderBreakout.drl]
2016-04-25 Tentative location for LED
    [MotorEncoderBoard.sch]
2016-04-25 New changes to the test firmware
    [EncoderWheel-Rev6.skp, EncoderWheel-Rev6~.skp]
2016-05-16 Added more code for testing the wheels
2016-05-17 Added indicator LED
    [MotorEncoderBoard.sch]
2016-05-20 Enhanced the board with indicator LEDs
    [MotorEncoderBoard.kicad_pcb, MotorEncoderBoard.sch]
2016-06-04 Firmware for the Nucleo - with small test case for both wheels
2016-06-20 Changed the port/pin assignments from Nucleo to Central Command
2016-06-20 Added the fix for the system clock as per Ron's testing the clock CC video
    [main.c]
2016-07-05 Added a crude synchronisation mechanism for the wheels
2016-10-29 RWI57 - A refactoring pass to move on - Created the Wheel.c/h
2016-10-29 RWI48 - Ceedlin & Unity to TDD Wheel Code
2016-10-30 RWI49: Broke out the Delegated IRQ handler to its own class
    [Wheel_IRQ_Delegate.c, Wheel_IRQ_Delegate.h, test_Wheel.c]
2016-11-01 Added the tests for the Wheel API
